VibhuKavBhat/ED25519-ASIC-Implementation/docs/ED25519_dark.png

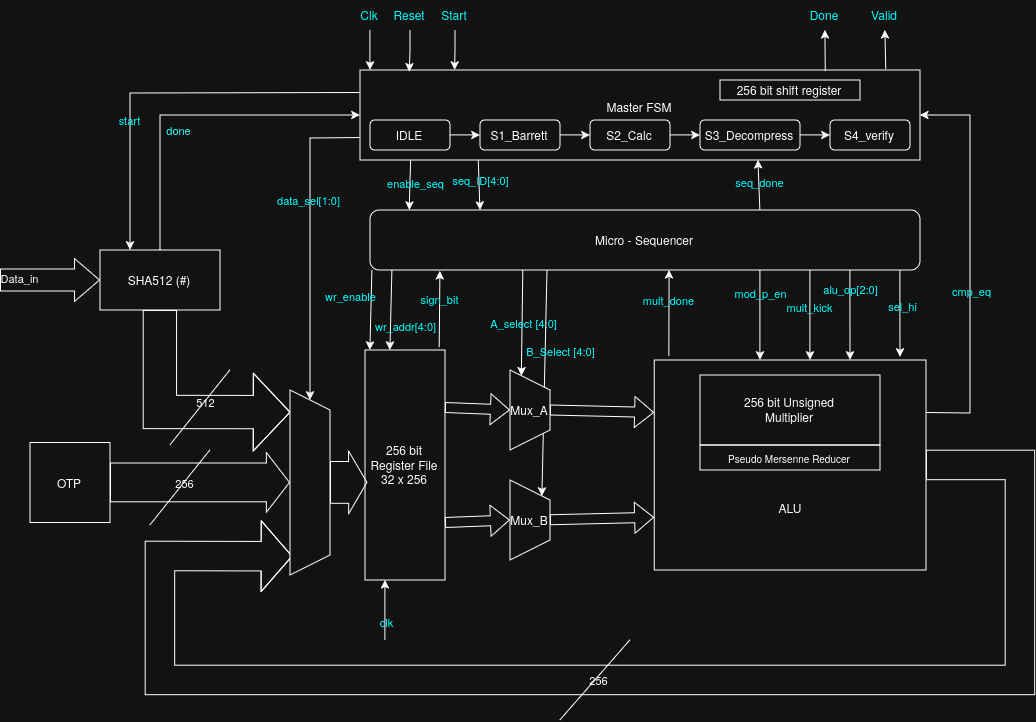
docs/ED25519_dark.png
